ouyangcong3/p4004_manual_PCB/MCS-4/redrawn-4004-schematics-2006-11-12.pdf

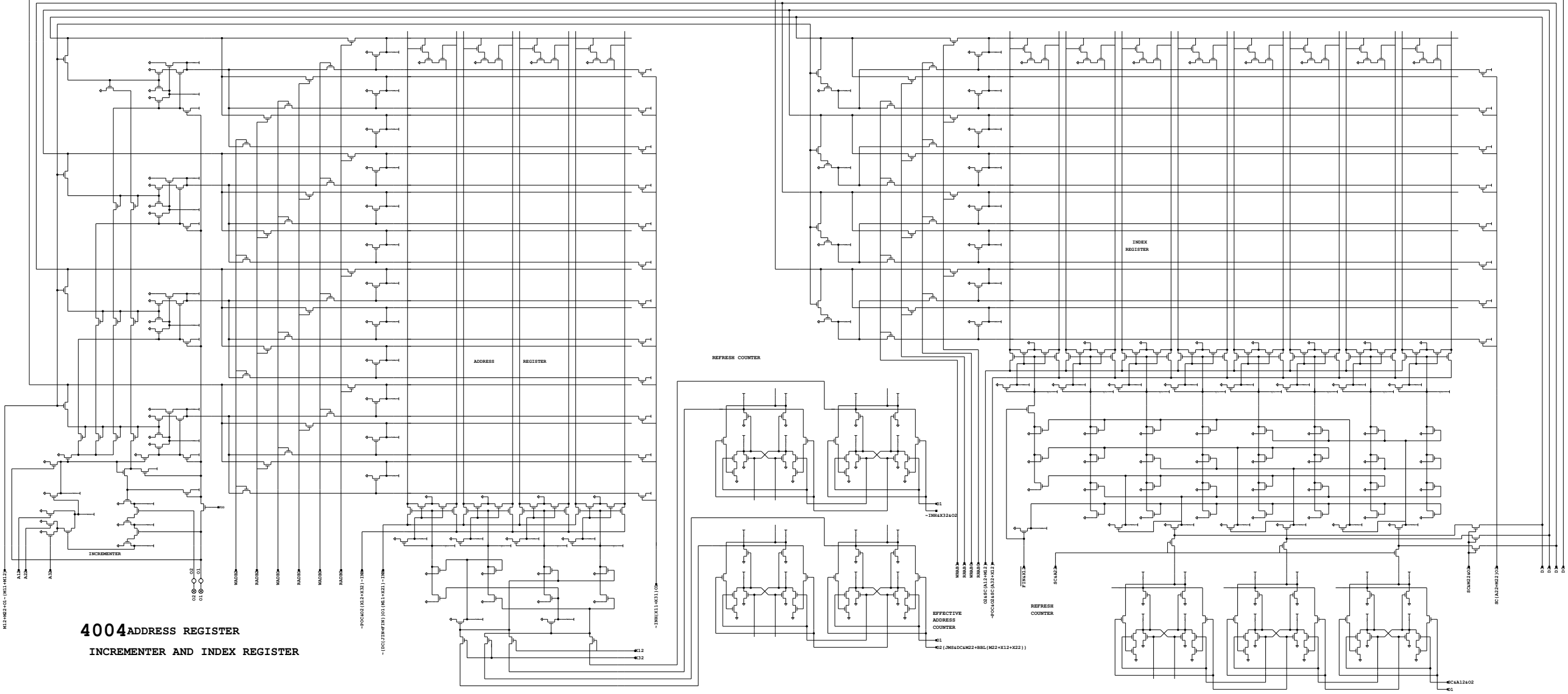
[picture p1: figure]
ADDRESS; REGISTER; INDEX; REFRESH COUNTER; 4004ADDRESS REGISTER; EFFECTIVE ADDRESS COUNTER; INCREMENTER AND INDEX REGISTER; RRAB; INCREMENTER; ~INH&X32&O2; VDD; RAB; WAD; RAD; O2{JMS&DC&M22+BBL{M22+X12+X22}}

B

D0 | 1
| 2
| 3
| 4
| 5
| 6
| 7
| 8 9

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
CLK1
CLK2
SYNC | POC TEST

CM ROM

VDD

CM RAM3

CM RAM2

CM RAM1

CM RAM 0

PIN CONFIGURATION

GATE PROTECTION

TO OR FROM PAD

GND

VDD

=

=

Re-drawn schematics based on Revision G of the original Intel 4004 schematics by Intel Corporation (August 6, 1976). Schematic capture and design verification by Fred Huettig, Brian Silverman and Barry Silverman (February 2, 2006). -------------------------------------------------------------You are free:

Under the following conditions:

* to make derivative works

* to copy, distribute, display, and perform this work

Attribution. You must attribute the work in the manner specified by the author or licensor.
Noncommercial. You may not use this work for commercial purposes. Share Alike. If you alter, transform, or build upon this
work, you may distribute the resulting work
only under a license identical to this one.
* For any reuse or distribution, you must make clear to others the license terms of this work.
* Any of these conditions can be waived if you get permission from the copyright holder.
Your fair use and other rights are in no way affected by the above.
This is a human-readable summary of the Legal Code
(the full license) available at: http://creativecommons.org/licenses/by-nc-sa/2.5/legalcode Intel is a registered trademark of the Intel Corporation

## Sheet 1 of 3

Re-drawn schematics based on Revision G of the original Intel 4004 schematics by Intel Corporation (August 6, 1976). Schematic capture and design verification by Fred Huettig, Brian Silverman and Barry Silverman (February 2, 2006). -------------------------------------------------------------You are free:

Under the following conditions:

* to make derivative works

* to copy, distribute, display, and perform this work

Attribution. You must attribute the work in the manner specified by the author or licensor.
Noncommercial. You may not use this work for commercial purposes. Share Alike. If you alter, transform, or build upon this
work, you may distribute the resulting work
only under a license identical to this one.
* For any reuse or distribution, you must make clear to others the license terms of this work.
* Any of these conditions can be waived if you get permission from the copyright holder.
Your fair use and other rights are in no way affected by the above.
This is a human-readable summary of the Legal Code
(the full license) available at: http://creativecommons.org/licenses/by-nc-sa/2.5/legalcode Intel is a registered trademark of the Intel Corporation

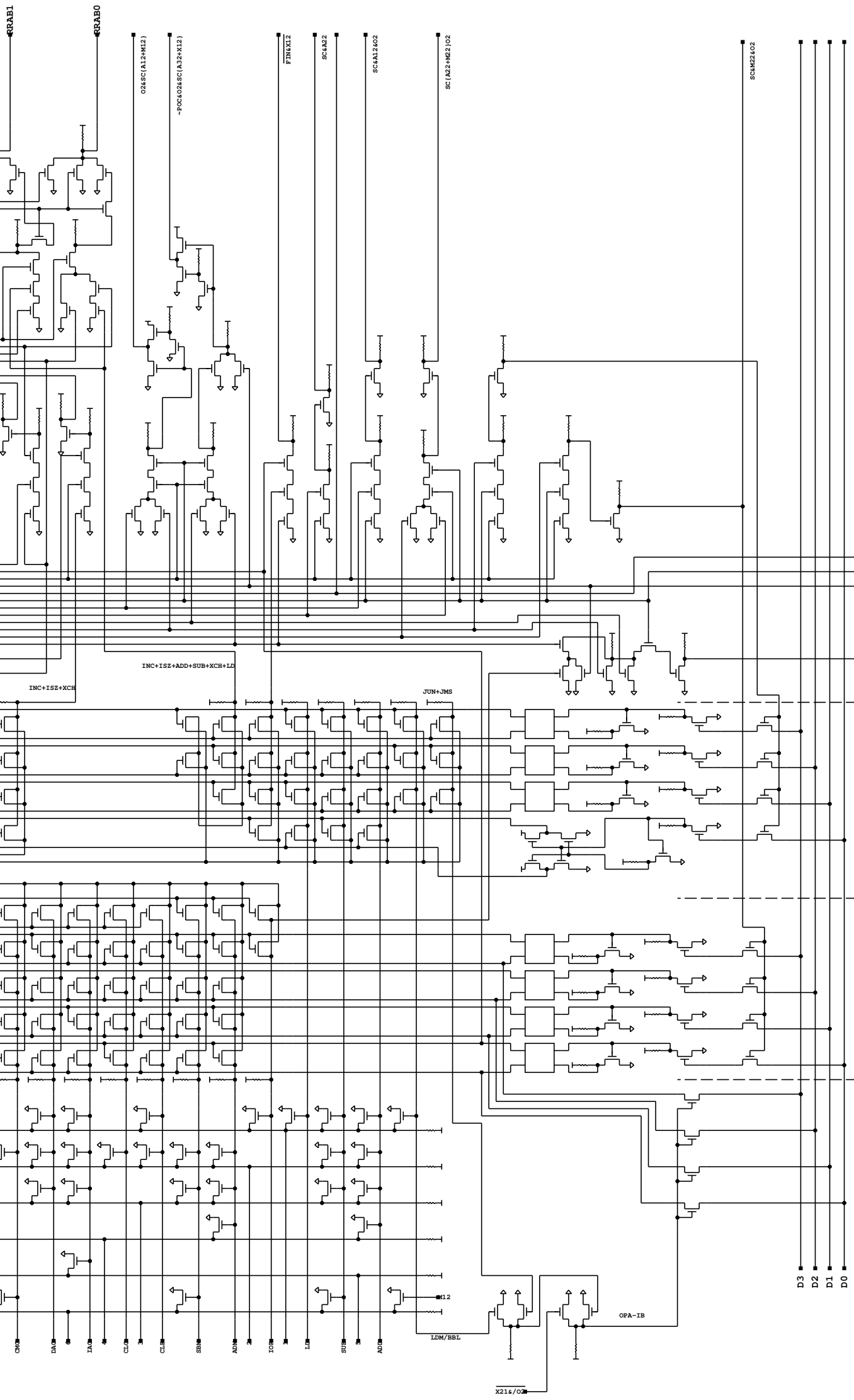
[picture p2: figure]
INC+ISZ+XCH; JUN+JMS; INC+ISZ+ADD+SUB+XCH+LD; RRAB; LDM/BBL; OPA-IB

### TO ADDER / ACCUMULATOR CONTROL

MEMORY
CONTROL

ADDRESS

## Sheet 2 of 3

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
FIN+FIM+SRC+JIN

SC

M

1

2

W

RAB

0

JIN+FIN JUN+JMS
JCN+ISE

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
FIM+SRC | IO | OPE

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
FIN+FIM

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
REGISTER

OPR

_

REGISTER

L

CONDITION

_

F/F

SINGLE

_

CYCLE

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
BBL | JMS ISZ | JCN

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
O1 | O2

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
MA RAL RAR DAA TCS

O

I

B

D

C

L

O1 | O2

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
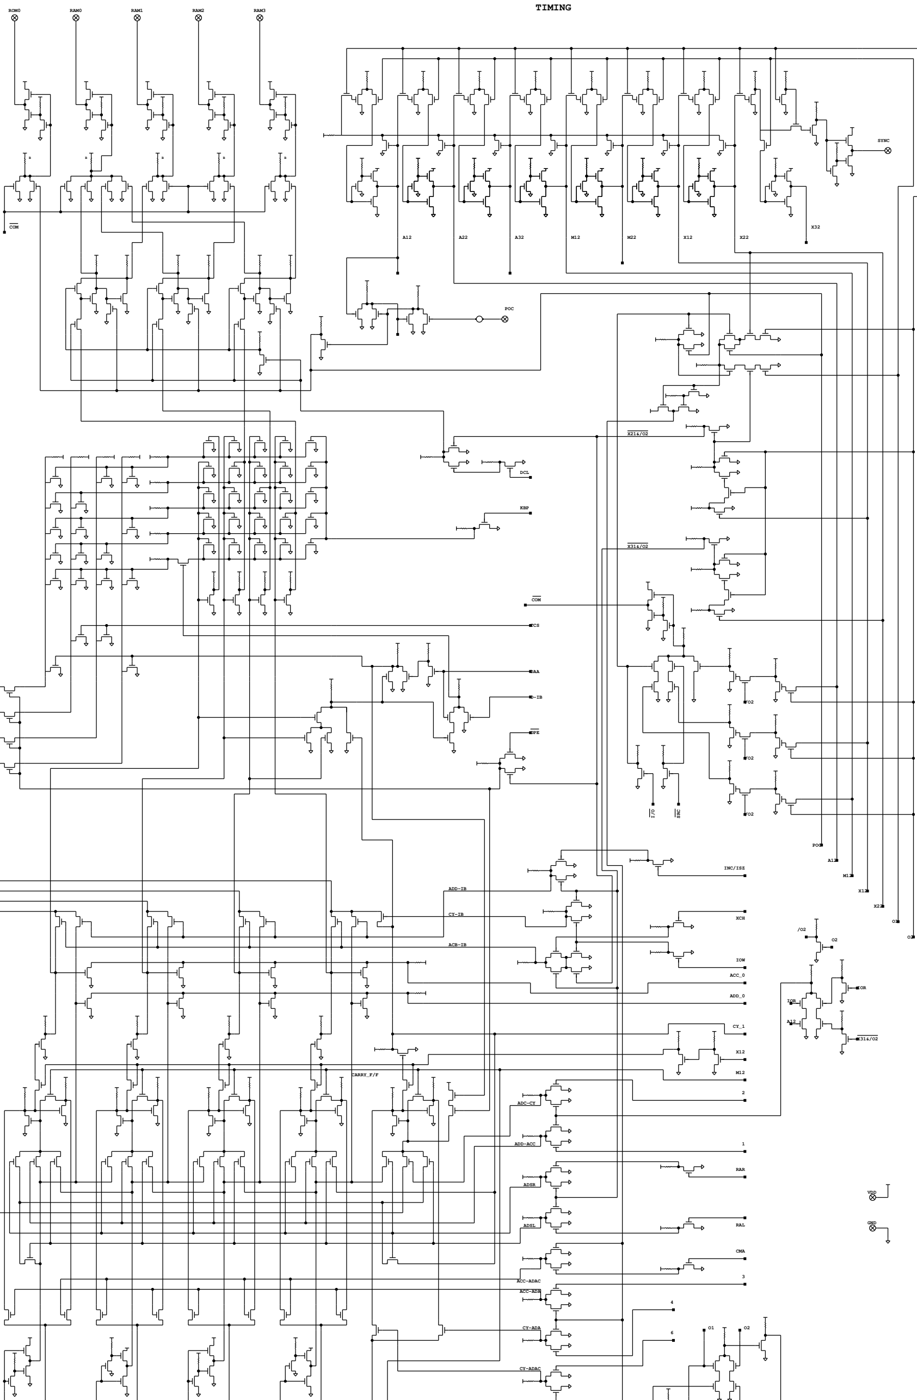
[picture p3: figure]
OIOI; ROM0; POC; SYNC; VDD; GND; RAM0; RAM1; RAM2; RAM3; ADSL; ADD-ACC; ADSR; ADC-CY; CY-ADAC; CY-ADA; CARRY; ACC-ADAC; ACC-ADA; TIMING; ACB-IB; ADD-IB; ACC; ADD; INC/ISZ; RAR; RAL; IOR; IOW; XCH; DAA; COM; TCS; KBP; DCL; OPE; CMA

B

B

Re-drawn schematics based on Revision G of the original Intel 4004 schematics by Intel Corporation (August 6, 1976). Schematic capture and design verification by Fred Huettig, Brian Silverman and Barry Silverman (February 2, 2006). -------------------------------------------------------------You are free:

Under the following conditions:

* to make derivative works

* to copy, distribute, display, and perform this work

Attribution. You must attribute the work in the manner specified by the author or licensor.
Noncommercial. You may not use this work for commercial purposes. Share Alike. If you alter, transform, or build upon this
work, you may distribute the resulting work
only under a license identical to this one.
* For any reuse or distribution, you must make clear to others the license terms of this work.
* Any of these conditions can be waived if you get permission from the copyright holder.
Your fair use and other rights are in no way affected by the above.
This is a human-readable summary of the Legal Code
(the full license) available at: http://creativecommons.org/licenses/by-nc-sa/2.5/legalcode Intel is a registered trademark of the Intel Corporation

/O2

/O2

/O2

## Sheet 3 of 3

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
BUFFER

_

0

IO

_

BUFFER

_

1

D1

L

IO

_

BUFFER

_

3

O1

IO

_

BUFFER

_

2

POC

O2

O1
