ouyangcong3/p4004_manual_PCB/MCS-4/4289.pdf

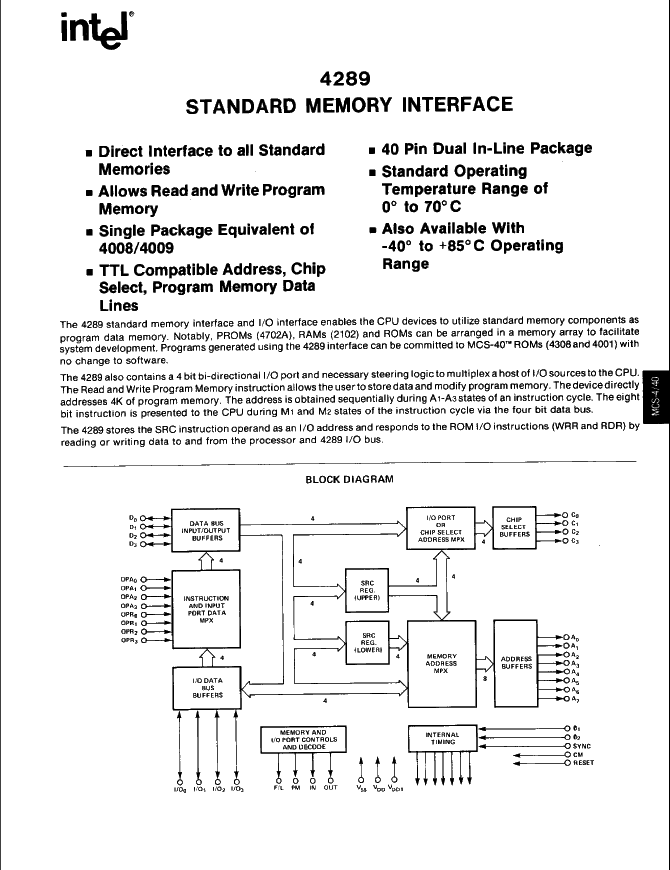
[picture p10: page 1]
