ouyangcong3/p4004_manual_PCB/MCS-4/Intel4003.pdf

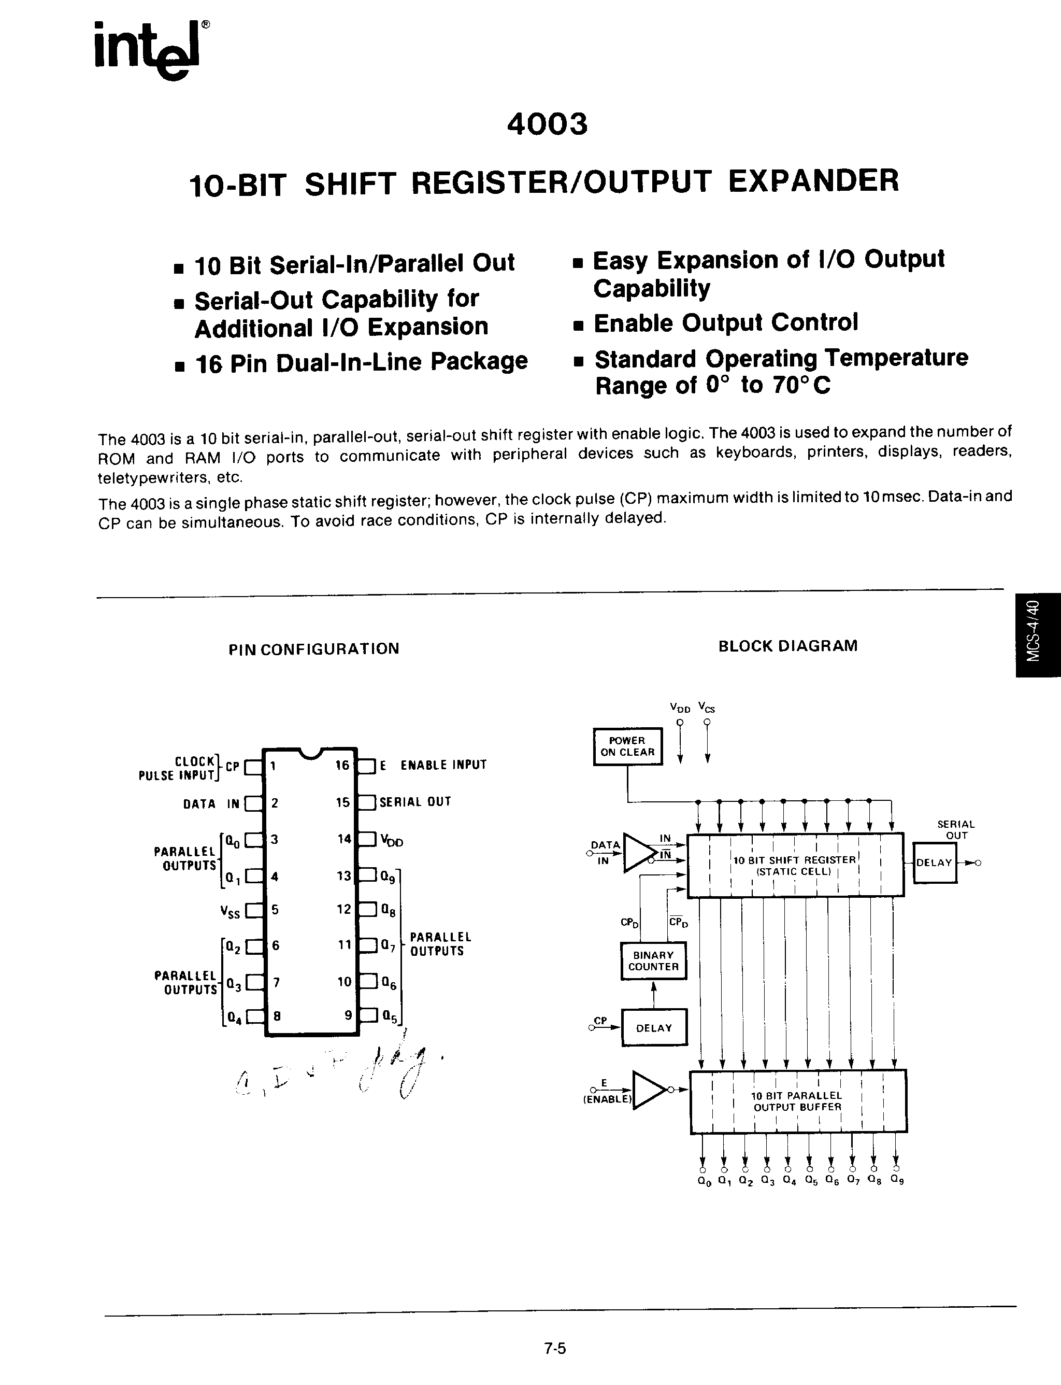
[picture p11: page 1]
