ouyangcong3/p4004_manual_PCB/MCS-4/4004最小系统.png

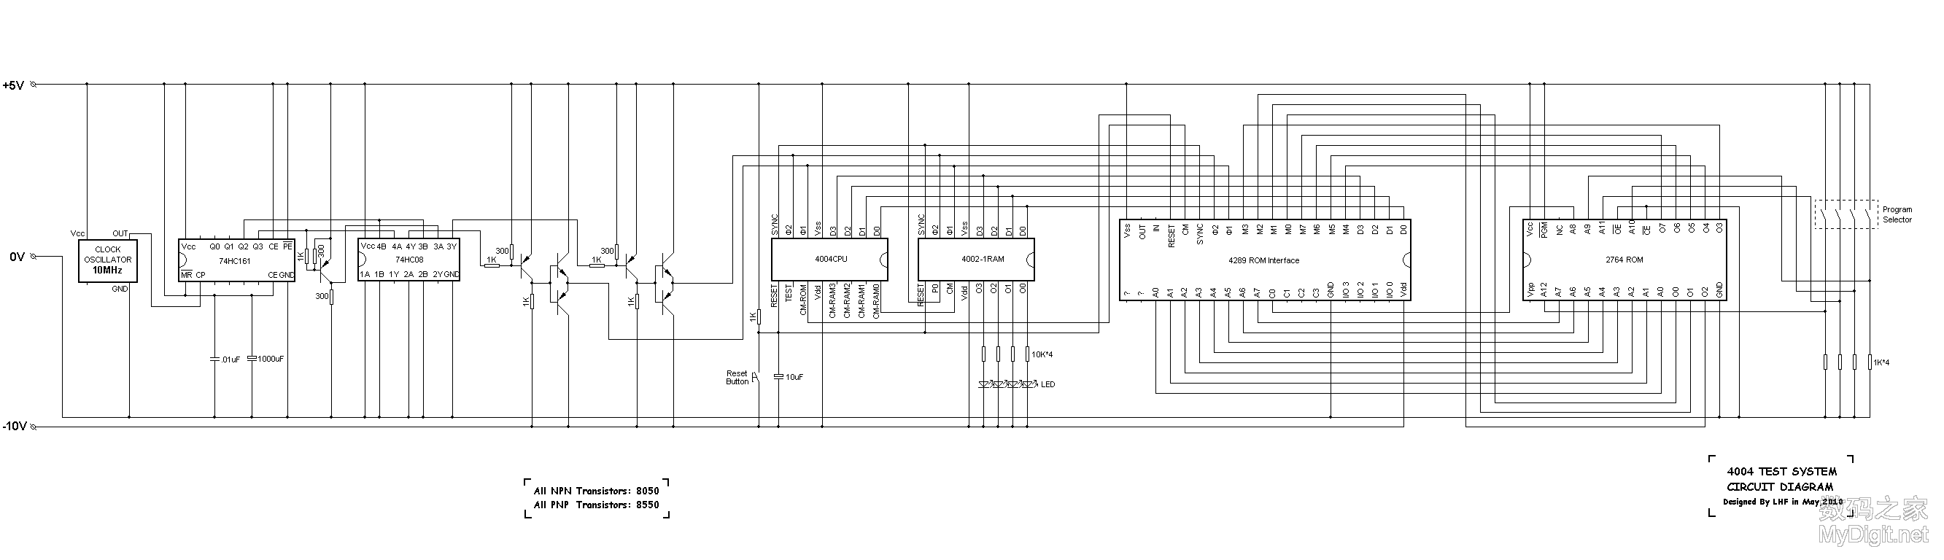
MCS-4/4004最小系统.png
