ouyangcong3/p4004_manual_PCB/MCS-4/BuscomV2p1.jpg

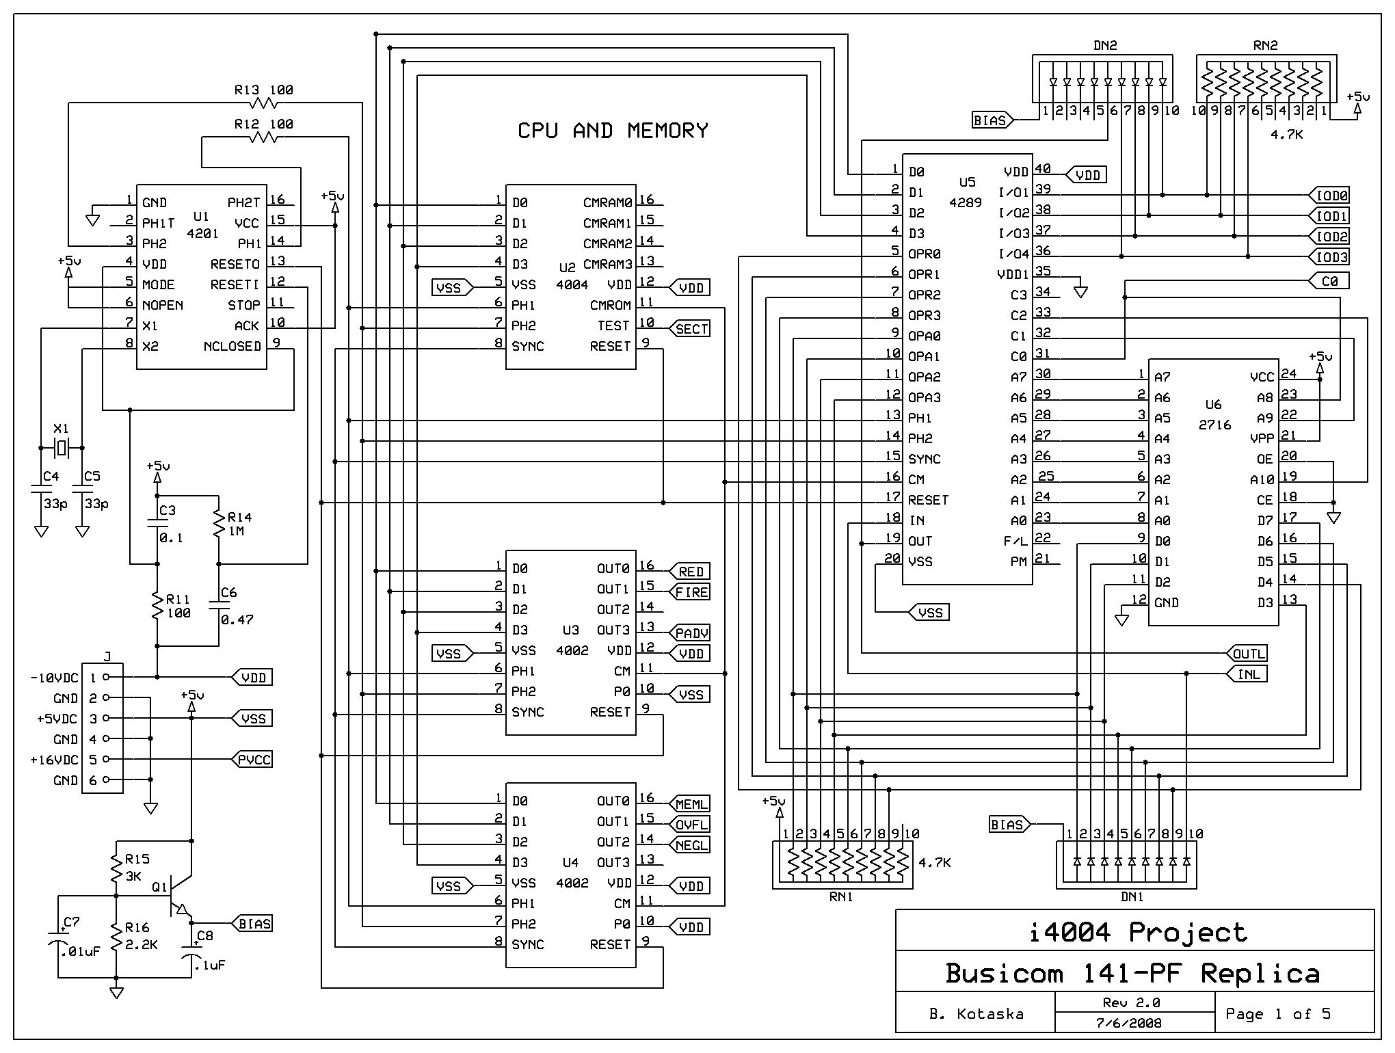
MCS-4/BuscomV2p1.jpg
