ouyangcong3/p4004_manual_PCB/MCS-4/i4001.gif

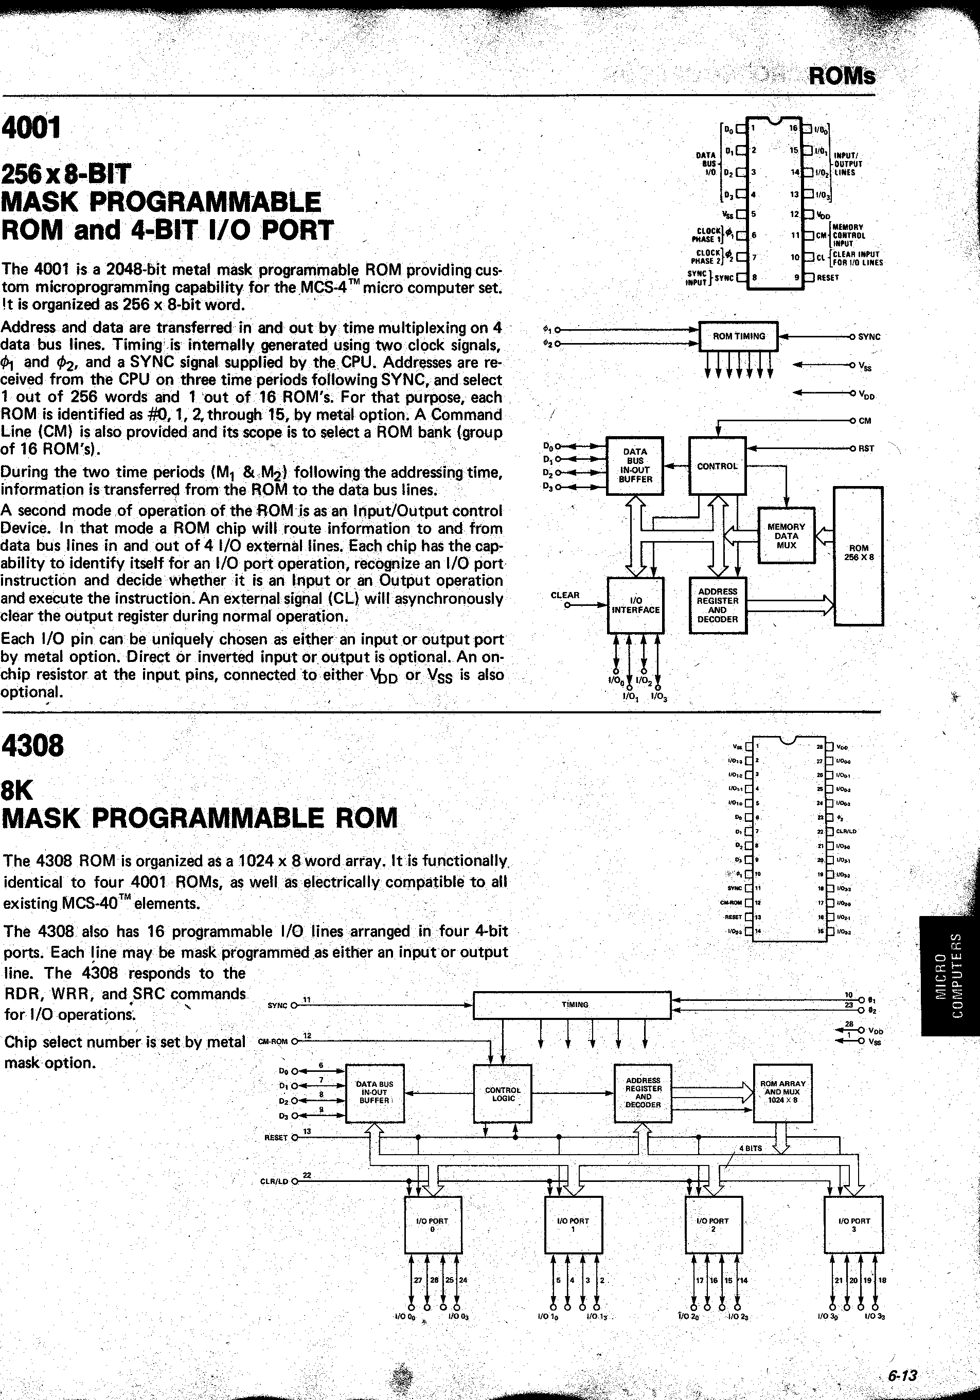
MCS-4/i4001.gif
