ouyangcong3/p4004_manual_PCB/MCS-4/清单.xls

 | 属性 | 数值 | 型号 | 厂商
C1 | capacitance电容 | 100nF
C2 |  | 100nF
C3 |  | 100nF
C4 | X5R | 10uF
C5 |  | 1uF
C6 |  | 100nF
C7 |  | 100nF
C8 |  | 100nF
C9 |  | 100nF
C10 |  | 100nF
C11 |  | 100nF
C12 |  | 100nF
C13 |  | 100nF
C14 |  | 10nF
C15 | X5R | 1uF
C16 |  | 100nF
C17 |  | 1uF
C18 |  | 100nF
C19 |  | 10uF
C20 |  | 100nF
C21 | X5R Ⅱ类陶瓷 | 10uF
C22 |  | 100nF
C23 |  | 10nF
C24 |  | 100nF
R1 |  | 1K
R2 |  | 10K
R3 |  | 10K
R4 |  | 10K
R5 |  | 220
R6 |  | 4.7K
R7 |  | 33K
R8 |  | 10K
R9 |  | 10K
R10 |  | 220
R11 |  | 10K
R12 |  | 10K
R13 |  | 1K
R14 |  | 1K
R15 |  | 1K
R16 |  | 1K
R17 | ? | 0.5R
R18 |  | 8.66K
R19 |  | 10K
R20 |  | 10K
R21 |  | 1K
R22 |  | 1K
R23 |  | 1K
R24 |  | 1K
R25 |  | 1K
R26 |  | 1K
R27 |  | 1K
R28 |  | 1K
R29 |  | 10K
R30 |  | 10K
R31 |  | 10K
R32 |  | 1K
R33 |  | 10K
R34 |  | 1K
R35 |  | 1K
R36 |  | 47
R37 |  | 47
R38 |  | 1K
R39 |  | 10K
R40 |  | 10K
R41 |  | 1K
R42 |  | 1K
R43 |  | 1K
R44
R45 |  | 1K
R46 |  | 1K
R47
R48
R49
R50 |  | 47K
U1 |  |  | LM393MX | ROHM [Rohm] | http://www.rohm.com
U2 | logic flip-flop |  | SN74HC74D | TI [Texas Instruments] | http://www.ti.com
U3 | logic gate 2 |  | SN74HC08D | TI [Texas Instruments] | http://www.ti.com
U4 | logic flip-flop |  | SN74HC74D | TI [Texas Instruments] | http://www.ti.com
U5 | Parallel 64 Kbit (8K x 8) EEPROM with Software Data Protection | ST-Microelectronics F盘库 | M28C64
U6 |  | 直插不在库 | C4040
U7 |  | 直插不在库 | C4004
U8 |  | 直插不在库 | C4002
U9 |  | 直插不在库 | C4289
U10 | logic decoder |  | SN74HC138D | TI [Texas Instruments] | http://www.ti.com
U11 | logic counter |  | SN74HC161D | TI [Texas Instruments] | http://www.ti.com
U12 | DC to DC Converter | LT Power Mgt DC-DC Converter | LT1931IS5 | LINER [Linear Technology] | http://www.linear.com
U13 | logic counter |  | SN74HC161D | TI [Texas Instruments] | http://www.ti.com
U14 | Low Power Low Offset Voltage Dual Comparator | National Semiconductor(NSC) F盘库 | LM393MX | ROHM [Rohm] | http://www.rohm.com
U15 |  | 不在库 | SN74HC125D | TI [Texas Instruments] | http://www.ti.com
U16 | logic decoder |  | SN74HC138D | TI [Texas Instruments] | http://www.ti.com
U17 | High Speed Dual MOSFET Drivers | F盘库 | MC34151 D? | motorola
L1 | 电感 INDUCTOR | 22uH
L2 | 电感 | 22uH
D1 | 肖特基二极管,其反向耐压为20V,整流电流(连续)为0.5A,瞬间(非重复)峰值电流为5A。 肖特基二极管通常用于整流、检波 | D Schottky | MBR0520 | MCC [Micro Commercial Components] | http://www.mccsemi.com
D2 | 二极管 | F盘库 Fairchild Semiconductor（FSC Discrete Diode） | 1N4148 |  | http://www.nxp.com
D3 | 二极管 |  | 1N4148
D4 | 发光二极管
D5 | 发光二极管
D6 | 发光二极管
D7 | 发光二极管
D8 | 发光二极管
D9 | 发光二极管
D10 | 发光二极管
D11 | 发光二极管
D12 | 发光二极管
D13 | 发光二极管
D14 | 发光二极管
D15 | 发光二极管
D16 | 发光二极管
D17 | 二极管 |  | 1N4148
D18 | 二极管 |  | 1N4148
D19 | 发光二极管 | 添加
Q1 | PNP三极管 | 添加
Q2 | PNP三极管
Q3 | PNP三极管
J1 | Jumper
J2 | Jumper
J3 | Mini_USB
S1 | SW DIP-2 | 添加
S2 | 按键 SW-PB | 添加
S3 | 按键
S4 | 按键
S5 | 按键
S6 | 按键
S7 | SW 开关
P1 | Header 4X2 | 添加 | 8针孔
P2 | Header 4X2 |  | 8针孔
P3 | Header 4X2 |  | 8针孔
P4 | Header 3X2 | 添加 | 6针孔
P5 | Header 3X2 |  | 6针孔
F1 | 1A点融丝？ | FUSE
X1 | 晶振 | SG7050CCN EPSON | ActiveCrystal_10MHz
