ouyangcong3/p4004_manual_PCB/MCS-4/MCS4Test_v3.pdf

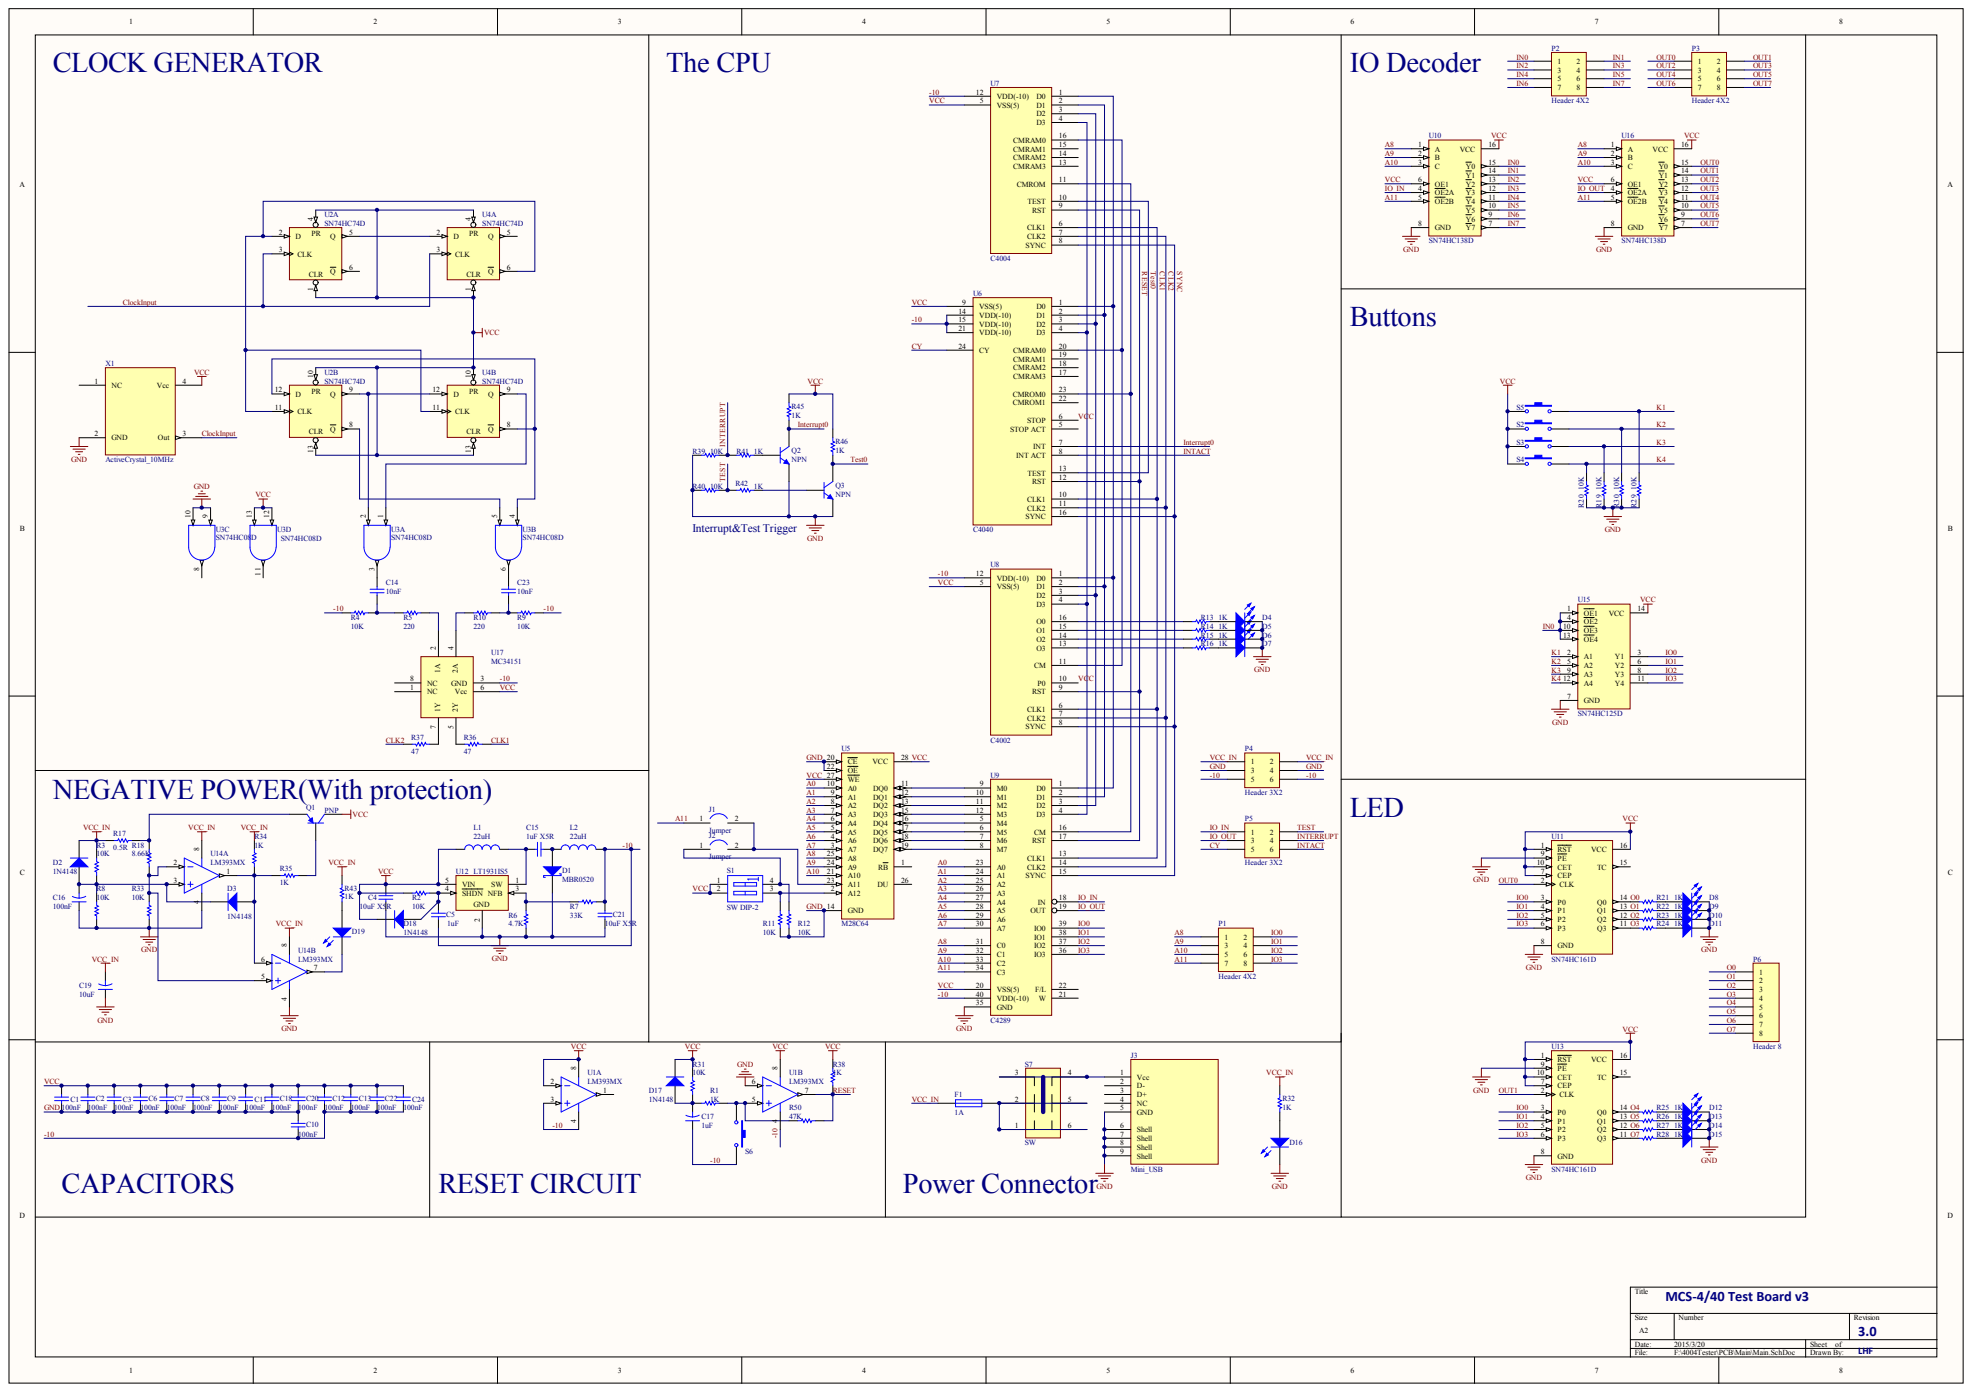
[picture p15: page 1]

NEGATIVE POWER(With protection)
