ouyangcong3/p4004_manual_PCB/mcs4/mcs4.pdf

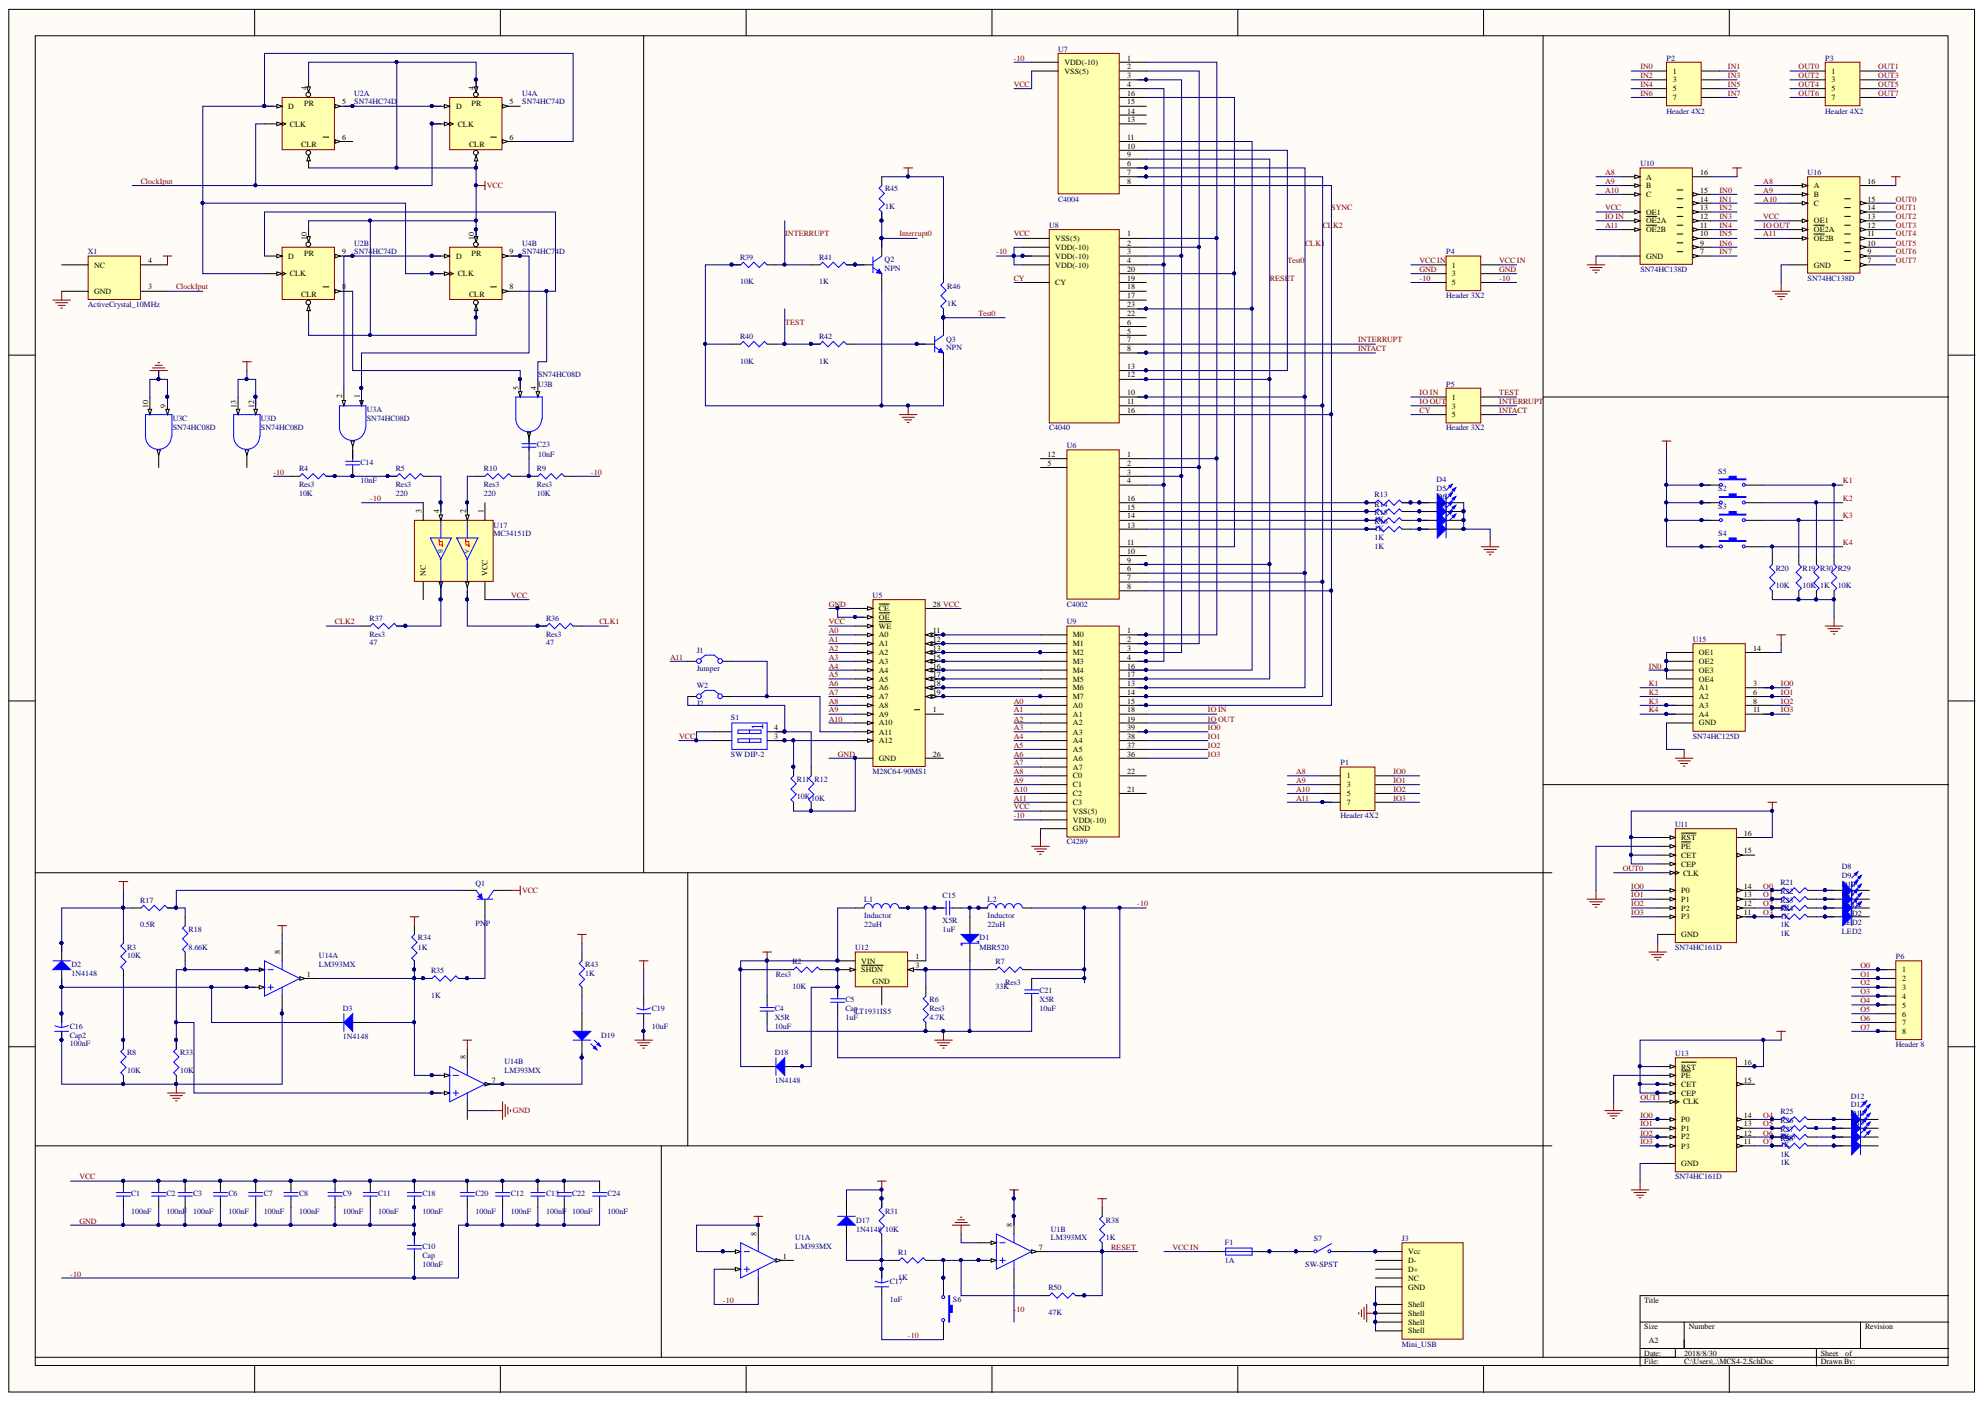
[picture p16: page 1]
