ouyangcong3/p4004_manual_PCB/(list of files, drawings)

Other design files:
mcs4/ActiveCrystal_10MHz.SchLib
mcs4/ActiveCrystal_10MHz_7050.PcbLib
mcs4/C4002.SchLib
mcs4/C4004.PcbLib
mcs4/C4004.SchLib
mcs4/C4040.SchLib
mcs4/C4289.PcbLib
mcs4/C4289.SchLib
mcs4/inductor1050-22uH.PcbLib
mcs4/Intel4001-4289chip.SchLib
mcs4/MCS4-2.SchDoc
mcs4/MCS4.PcbDoc
mcs4/mcs4.PrjPcb
mcs4/mcs4.SchDoc
mcs4/MCS4/C4004.PcbLib
mcs4/MCS4/C4004.SchLib
mcs4/Mini_USB.PcbLib
mcs4/Mini_USB.SchLib
mcs4/P4002.PcbLib
mcs4/P4002.SchLib
mcs4/P4004.PcbLib
mcs4/P4004.SchLib
mcs4/P4040.PcbLib
mcs4/P4040.SchLib
mcs4/PcbLib1.PcbLib
mcs4/SN74HC125D.PcbLib
mcs4/SN74HC125D.SchLib
mcs4/test28jiao.PcbLib
mcs4/usbmin2.PcbLib
mcs4/usbmin.PcbLib
